arhangoyal/GainSense/notebook/MPU6050-stable-state-eading.png

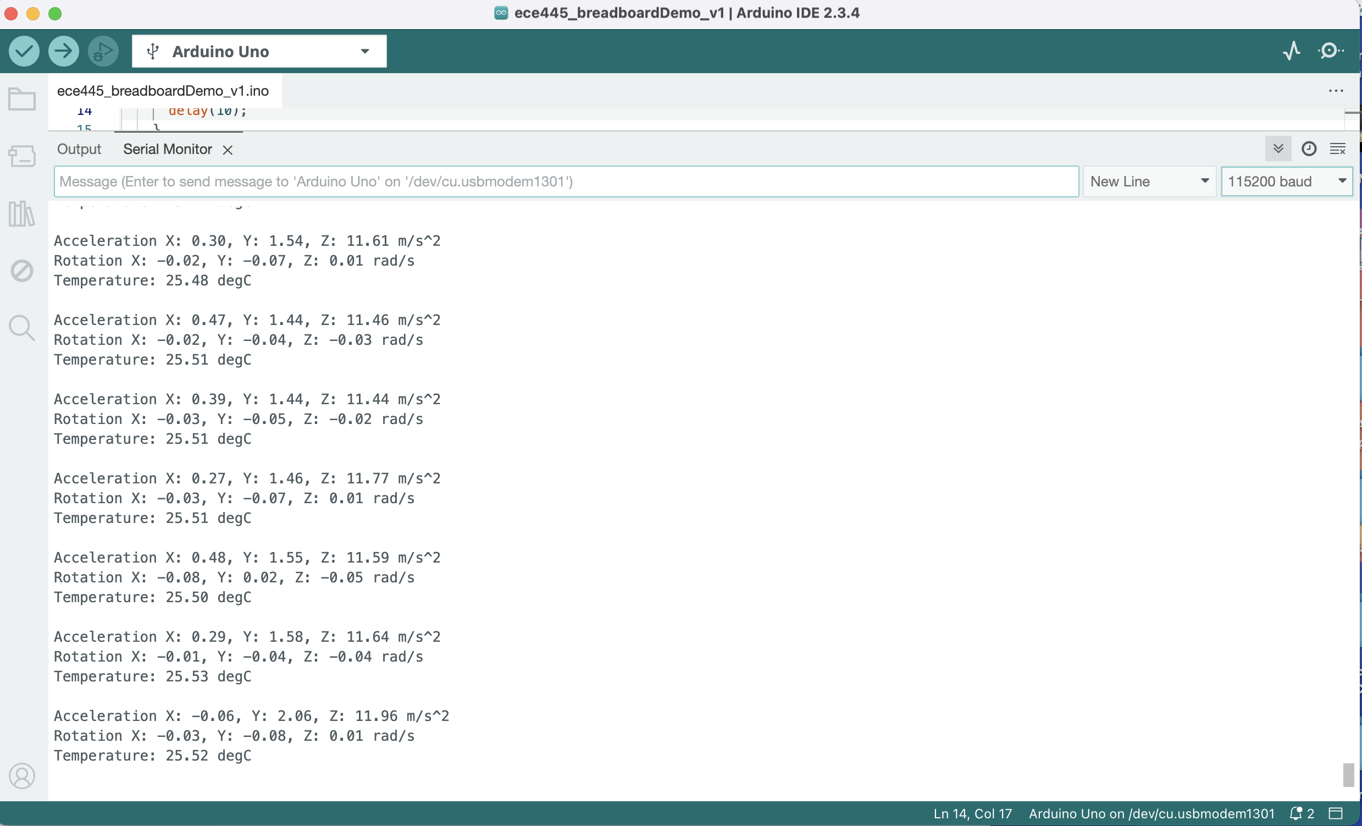
notebook/MPU6050-stable-state-eading.png
